sftp/thermometer/thermometer_pcb/Edge.Cuts.FCStd

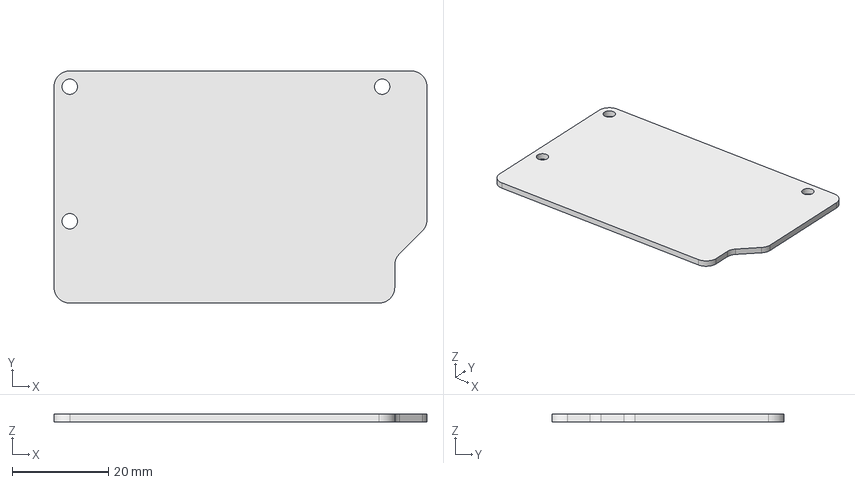
[picture p1: CAD file, 2020-10-15]
thermometer_pcb/Edge.Cuts.FCStd
77.6 x 48.3 x 1.60 mm
