sftp/thermometer/thermometer_pcb/thermometer_pcb.kicad_pcb

## KiCad design thermometer_pcb/thermometer_pcb.kicad_pcb (2024-02-26)

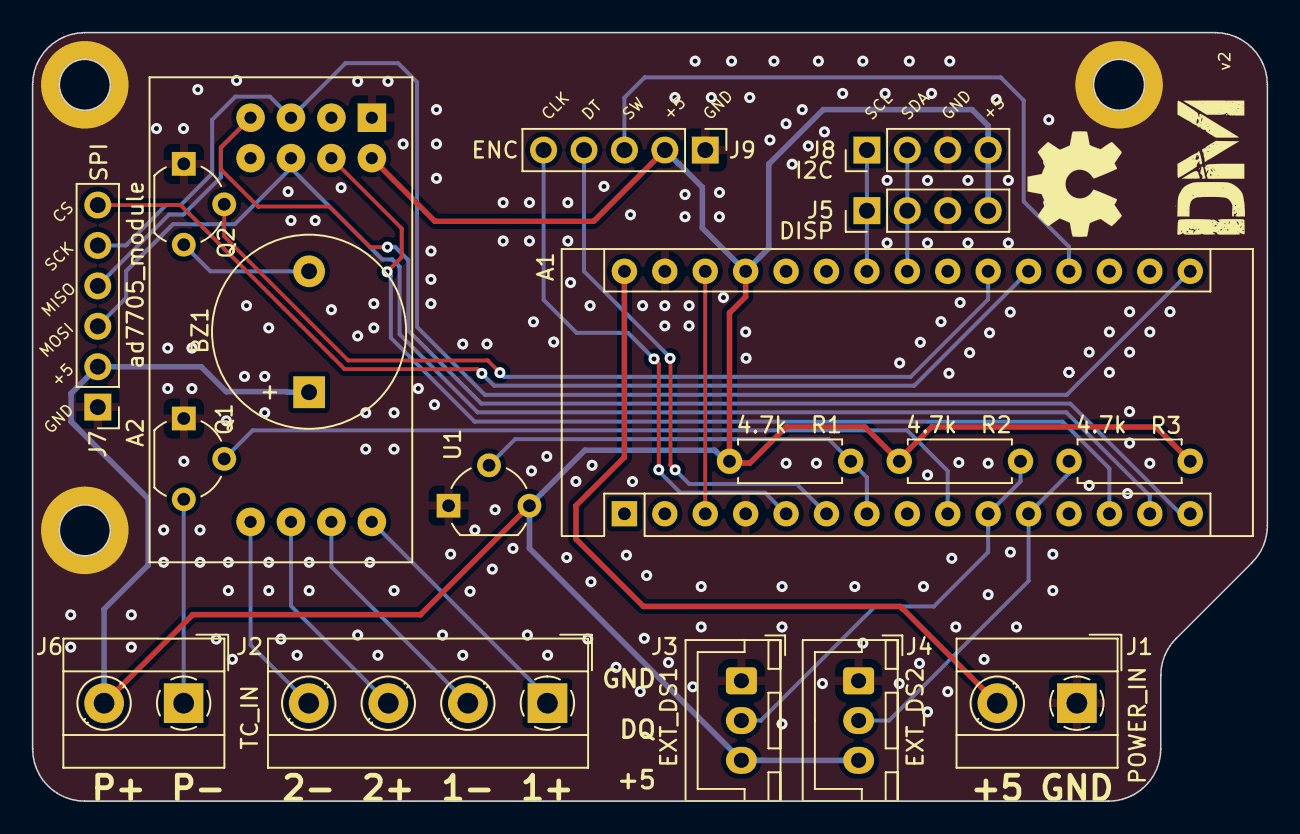
[picture p2: board thermometer_pcb.kicad_pcb from above]

Board: 2 copper layers, 77.6 x 48.3 mm, 23 parts (0 on the bottom side), 25 nets.

Parts:
A1: Arduino_Nano_v3.x; Arduino_Nano
A2: ad7705_module
BZ1: Buzzer; Buzzer_12x9.5RM7.6
H1, H2, H3: MountingHole_Pad; MountingHole_3.2mm_M3_ISO14580_Pad
J1: POWER_IN; TerminalBlock_MetzConnect_Type055_RT01502HDWU_1x02_P5.00mm_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
J2: TC_IN; TerminalBlock_MetzConnect_Type055_RT01504HDWU_1x04_P5.00mm_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
J3: EXT_DS1; JST_XH_B3B-XH-A_1x03_P2.50mm_Vertical
J4: EXT_DS2; JST_XH_B3B-XH-A_1x03_P2.50mm_Vertical
J5: DISP; PinHeader_1x04_P2.54mm_Vertical
J6: Conn_01x02; TerminalBlock_MetzConnect_Type055_RT01502HDWU_1x02_P5.00mm_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
J7: SPI; PinHeader_1x06_P2.54mm_Vertical
J8: I2C; PinHeader_1x04_P2.54mm_Vertical
J9: ENC; PinHeader_1x05_P2.54mm_Vertical
LOGO1: Logo_Open_Hardware_Small; OSHW-Symbol_6.7x6mm_SilkScreen
Q1, Q2: PN2222A; TO-92_Wide
R1, R2, R3: 4.7k; R_Axial_DIN0207_L6.3mm_D2.5mm_P7.62mm_Horizontal
SYM1: dm_logo
U1: DS18B20; TO-92_Wide

Connections:
+5V: A1.27, A2.2, BZ1.1, J3.3, J4.3, J5.4, J6.2, J7.2, J8.4, J9.2, R1.1, R2.1, R3.1, U1.3
/2: A1.5, J9.5
/3(**): A1.6, J9.4
/4: A1.7, R1.2, U1.2
/6(**): A1.9, Q1.2
/7: A1.10, J3.2, R2.2
/8: A1.11, J4.2, R3.2
/10(**/SS): A1.13, A2.4
/11(**/MOSI): A1.14, A2.6, J7.3
/12(MISO): A1.15, A2.7, J7.4
/13(SCK): A1.16, A2.5, J7.5
/A0: A1.19, J9.3
/A1: A1.20, J7.6
/A2: A1.21, Q2.2
/A4: A1.23, J5.2, J8.2
/A5: A1.24, J5.1, J8.1
/AIN1+: A2.9, J2.1
/AIN1-: A2.10, J2.2
/AIN2+: A2.11, J2.3
/AIN2-: A2.12, J2.4
/PID_OUT-: J6.1, Q1.3
/Reset: A1.3, A1.28
/Vin: A1.30, J1.2
GND: A1.4, A1.29, A2.1, H1.1, H2.1, H3.1, J1.1, J3.1, J4.1, J5.3, J7.1, J8.3, J9.1, Q1.1, Q2.1, U1.1
unnamed: BZ1.2, Q2.3
