sftp/thermometer/tc_pcb/tc_pcb.kicad_pcb

## KiCad design tc_pcb/tc_pcb.kicad_pcb (2024-02-26)

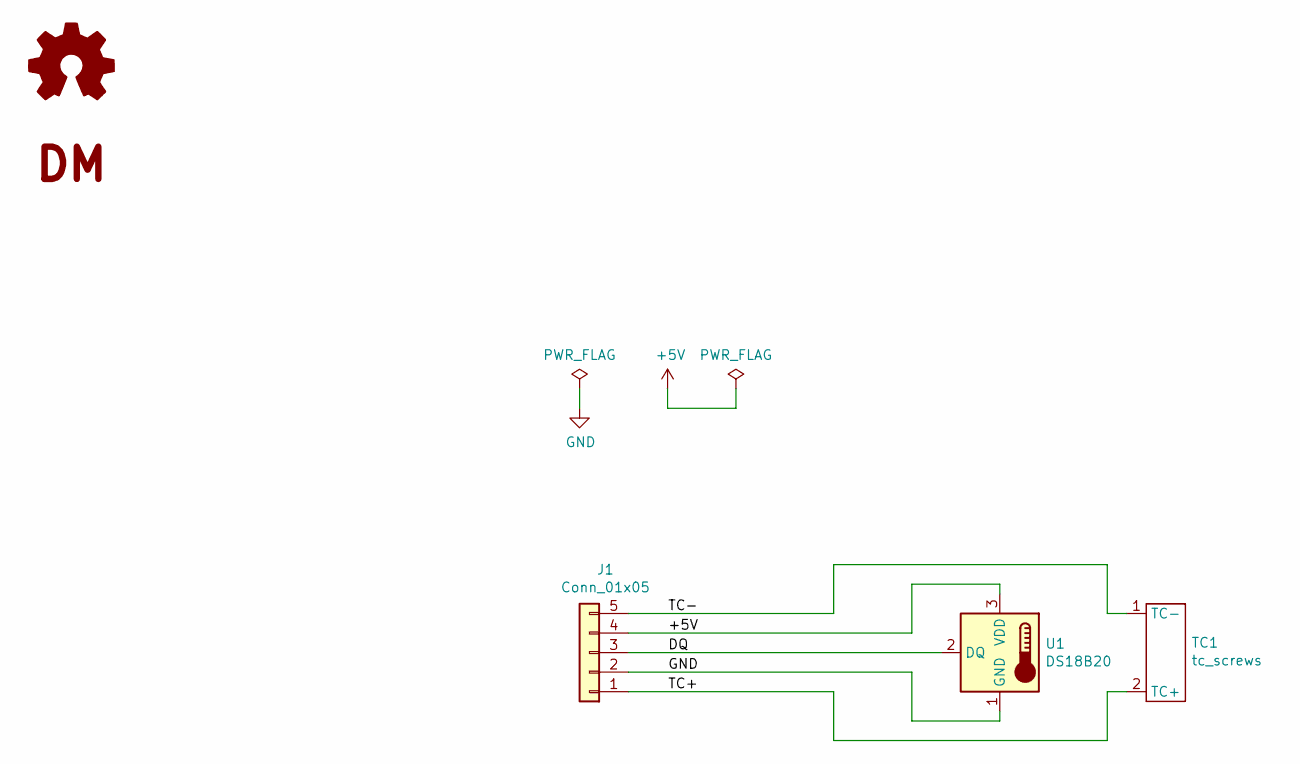
[picture p3: schematic tc_pcb.kicad_sch]

Parts:
J1: Conn_01x05; PinSocket_1x05_P2.54mm_Vertical
LOGO1: Logo_Open_Hardware_Small; OSHW-Symbol_6.7x6mm_SilkScreen
SYM1: dm_logo
TC1: tc_screws
U1: DS18B20; TO-92_W4.0mm_StaggerEven_Horizontal_FlatSideDown

Connections:
+5V: J1.4, U1.3 (VDD)
/DQ: J1.3, U1.2 (DQ)
/TC+: J1.1, TC1.2 (TC+)
/TC-: J1.5, TC1.1 (TC-)
GND: J1.2, U1.1 (GND)

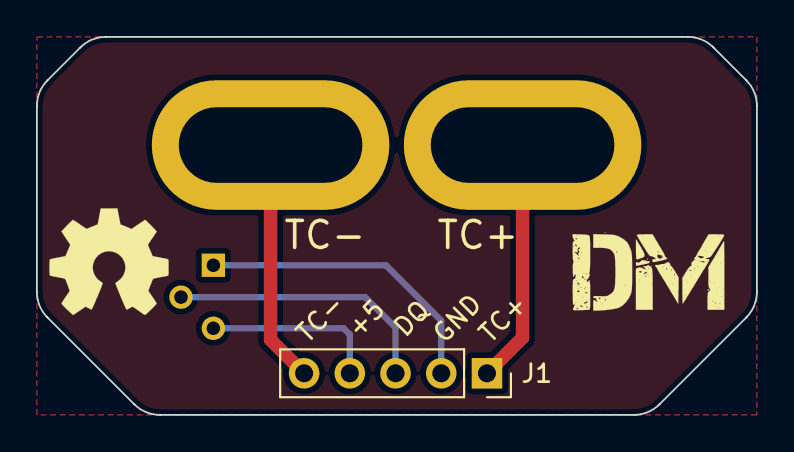
[picture p4: board tc_pcb.kicad_pcb from above]

Board: 2 copper layers, 40.0 x 21.0 mm, 5 parts (1 on the bottom side), 5 nets.
