sftp/thermometer/ad7705_pcb/ad7705_pcb.kicad_pcb

## KiCad design ad7705_pcb/ad7705_pcb.kicad_pcb (2020-07-26)

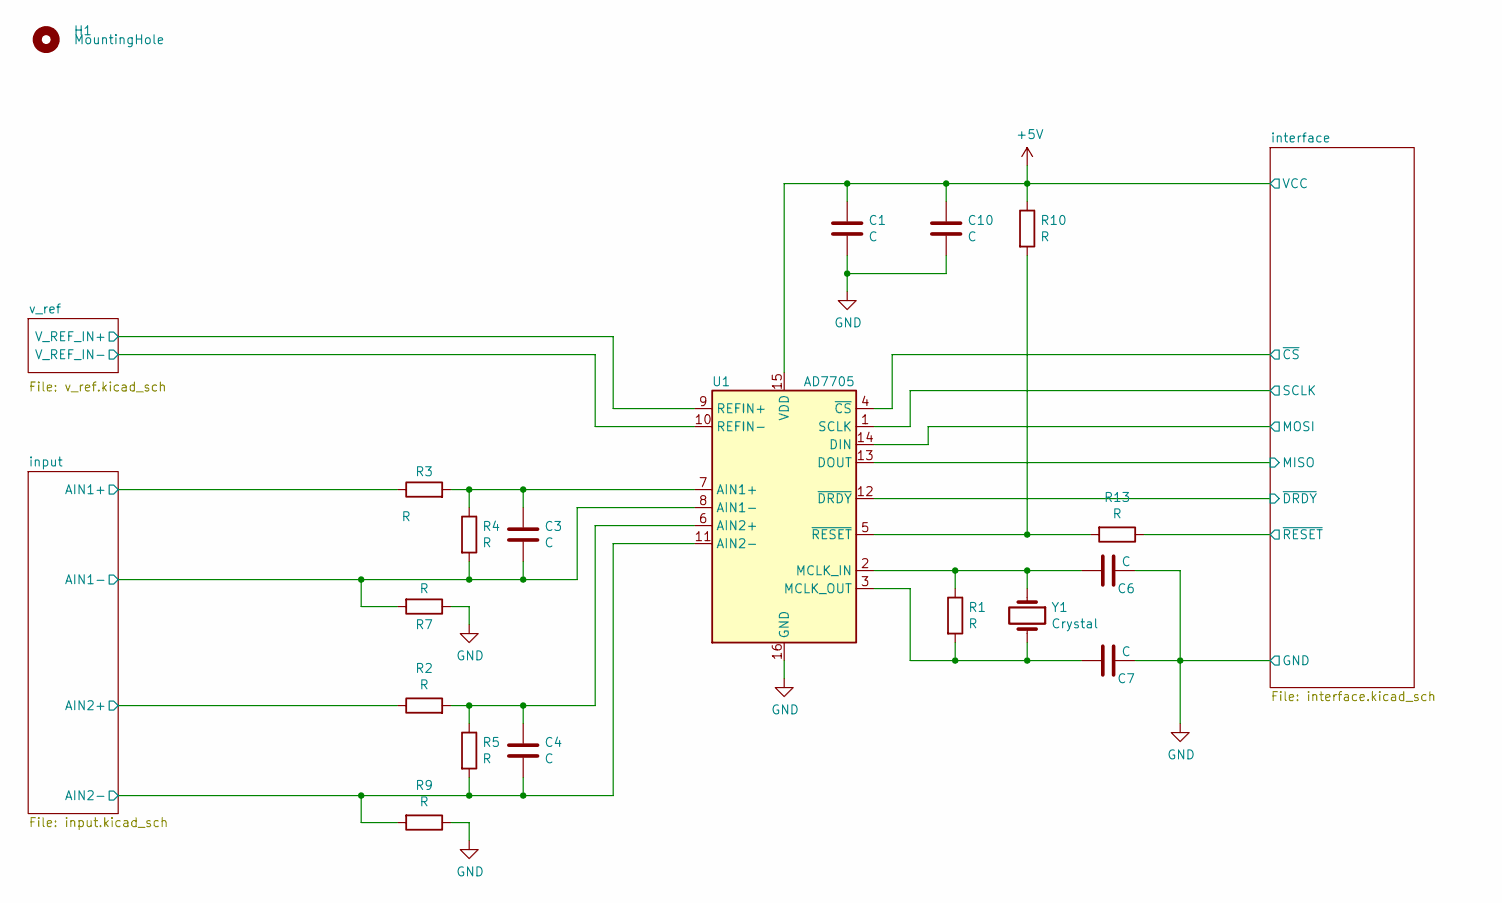
[picture p5: schematic ad7705_pcb.kicad_sch, AD7705 Module]

Parts:
C1, C3, C4, C6, C7, C10: C; C_0603_1608Metric
H1: MountingHole; MountingHole_2.2mm_M2_ISO7380
R1, R2, R3, R4, R5, R7, R9, R10, R13: R; R_0603_1608Metric
U1: AD7705; SOIC-16_4.55x10.3mm_P1.27mm
Y1: Crystal; Crystal_HC49-4H_Vertical

Connections:
+5V: C1.1, C10.1, R10.1, U1.15 (VDD); also elsewhere on the board
/AIN1+: R3.1; also elsewhere on the board
/AIN1-: C3.1, R4.2, R7.2, U1.8 (AIN1-); also elsewhere on the board
/AIN2+: R2.1; also elsewhere on the board
/AIN2-: C4.1, R5.2, R9.2, U1.11 (AIN2-); also elsewhere on the board
/MISO: U1.13 (DOUT); also elsewhere on the board
/MOSI: U1.14 (DIN); also elsewhere on the board
/SCLK: U1.1 (SCLK); also elsewhere on the board
/V_REF_IN+: U1.9 (REFIN+); also elsewhere on the board
/V_REF_IN-: U1.10 (REFIN-); also elsewhere on the board
/~CS: U1.4 (~CS); also elsewhere on the board
/~DRDY: U1.12 (~DRDY); also elsewhere on the board
/~RESET: R13.1; also elsewhere on the board
GND: C1.2, C6.1, C7.1, C10.2, R7.1, R9.1, U1.16 (GND); also elsewhere on the board
unnamed: C3.2, R3.2, R4.1, U1.7 (AIN1+)
unnamed: C4.2, R2.2, R5.1, U1.6 (AIN2+)
unnamed: C6.2, R1.1, U1.2 (MCLK_IN), Y1.1
unnamed: C7.2, R1.2, U1.3 (MCLK_OUT), Y1.2
unnamed: R10.2, R13.2, U1.5 (~RESET)

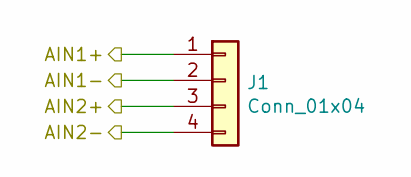
[picture p6: schematic input.kicad_sch, AD7705 Module]

Parts:
J1: Conn_01x04; PinHeader_1x04_P2.54mm_Vertical

Connections:
/AIN1+: J1.1; also elsewhere on the board
/AIN1-: J1.2; also elsewhere on the board
/AIN2+: J1.3; also elsewhere on the board
/AIN2-: J1.4; also elsewhere on the board

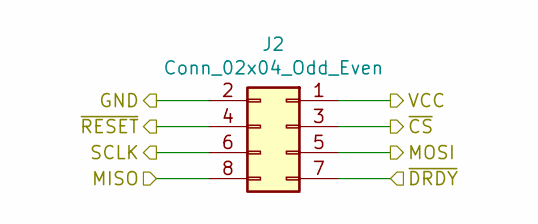
[picture p7: schematic interface.kicad_sch, AD7705 Module]

Parts:
J2: Conn_02x04_Odd_Even; PinHeader_2x04_P2.54mm_Vertical

Connections:
+5V: J2.1; also elsewhere on the board
/MISO: J2.8; also elsewhere on the board
/MOSI: J2.5; also elsewhere on the board
/SCLK: J2.6; also elsewhere on the board
/~CS: J2.3; also elsewhere on the board
/~DRDY: J2.7; also elsewhere on the board
/~RESET: J2.4; also elsewhere on the board
GND: J2.2; also elsewhere on the board

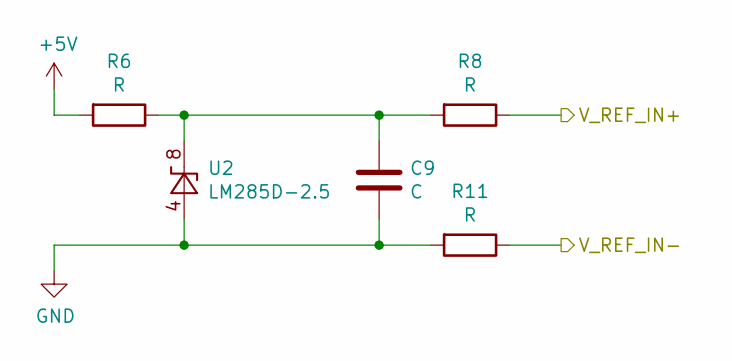
[picture p8: schematic v_ref.kicad_sch, AD7705 Module]

Parts:
C9: C; C_0603_1608Metric
R6, R8, R11: R; R_0603_1608Metric
U2: LM285D-2.5; SOIC-8_3.9x4.9mm_P1.27mm

Connections:
+5V: R6.2; also elsewhere on the board
/V_REF_IN+: R8.1; also elsewhere on the board
/V_REF_IN-: R11.1; also elsewhere on the board
GND: C9.2, R11.2, U2.4 (A); also elsewhere on the board
unnamed: C9.1, R6.1, R8.2, U2.8 (K)

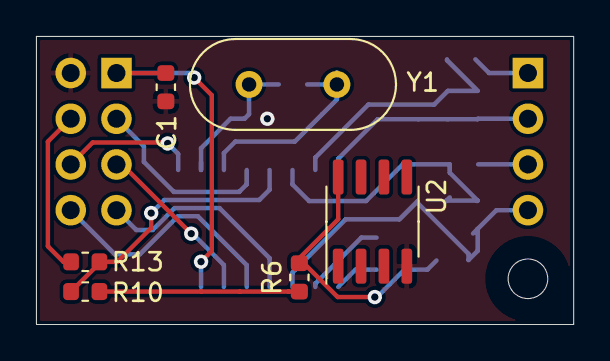
[picture p9: board ad7705_pcb.kicad_pcb from above]

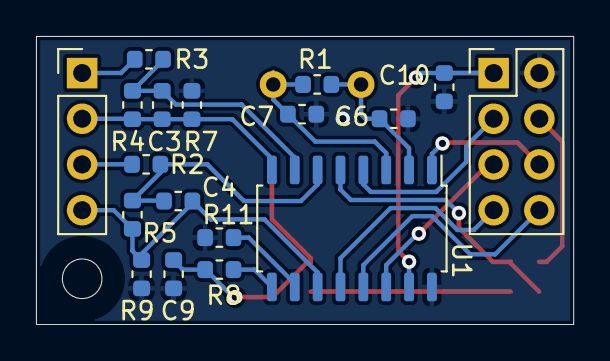
[picture p10: board ad7705_pcb.kicad_pcb from below]

Board: 2 copper layers, 29.8 x 16.0 mm, 25 parts (18 on the bottom side), 20 nets.
