sftp/thermometer/tc_k.h

#define TABLE_SIZE 1396
#define TABLE_STEP 33
#define TC_GAIN TC_GAIN_64

const uint16_t TABLE[TABLE_SIZE] PROGMEM = {
  0, /* t=0.0; mV=0.0; ADC=0 */
  9, /* t=0.9868700167607088; mV=0.03933906555175781; ADC=33 */
  19, /* t=1.9738946332880558; mV=0.07867813110351562; ADC=66 */
  29, /* t=2.9609894134174706; mV=0.11801719665527344; ADC=99 */
  39, /* t=3.9480744284351186; mV=0.15735626220703125; ADC=132 */
  49, /* t=4.935074124672115; mV=0.19669532775878906; ADC=165 */
  59, /* t=5.9219171936188655; mV=0.23603439331054687; ADC=198 */
  69, /* t=6.908536444527972; mV=0.2753734588623047; ADC=231 */
  78, /* t=7.8948686794743566; mV=0.3147125244140625; ADC=264 */
  88, /* t=8.880854570841494; mV=0.3540515899658203; ADC=297 */
  98, /* t=9.866438541202918; mV=0.3933906555175781; ADC=330 */
  108, /* t=10.851568645568385; mV=0.43272972106933594; ADC=363 */
  118, /* t=11.83619645596427; mV=0.47206878662109375; ADC=396 */
  128, /* t=12.820276948318122; mV=0.5114078521728516; ADC=429 */
  138, /* t=13.803768391617377; mV=0.5507469177246094; ADC=462 */
  147, /* t=14.786632239312661; mV=0.5900859832763672; ADC=495 */
  157, /* t=15.768833022936166; mV=0.629425048828125; ADC=528 */
  167, /* t=16.750338247905923; mV=0.6687641143798828; ADC=561 */
  177, /* t=17.731118291486972; mV=0.7081031799316406; ADC=594 */
  187, /* t=18.71114630288079; mV=0.7474422454833984; ADC=627 */
  196, /* t=19.69039810541422; mV=0.7867813110351562; ADC=660 */
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
  13683, /* t=1368.3102738166826; mV=54.759979248046875; ADC=45936 */
  13694, /* t=1369.4746384924258; mV=54.79931831359863; ADC=45969 */
  13706, /* t=1370.6397040486831; mV=54.83865737915039; ADC=46002 */
  13718, /* t=1371.8054723313448; mV=54.87799644470215; ADC=46035 */
};
