sftp/thermometer/tc_n.h

#define TABLE_SIZE 1329
#define TABLE_STEP 30
#define TC_GAIN TC_GAIN_64

const uint16_t TABLE[TABLE_SIZE] PROGMEM = {
  0, /* t=0.0; mV=0.0; ADC=0 */
  13, /* t=1.382265359451432; mV=0.035762786865234375; ADC=30 */
  27, /* t=2.7617742029994634; mV=0.07152557373046875; ADC=60 */
  41, /* t=4.138539433739884; mV=0.10728836059570312; ADC=90 */
  55, /* t=5.512573953056234; mV=0.1430511474609375; ADC=120 */
  68, /* t=6.883890659816768; mV=0.17881393432617187; ADC=150 */
  82, /* t=8.252502449579438; mV=0.21457672119140625; ADC=180 */
  96, /* t=9.618422213804884; mV=0.2503395080566406; ADC=210 */
  109, /* t=10.98166283907742; mV=0.286102294921875; ADC=240 */
  123, /* t=12.342237206333904; mV=0.3218650817871094; ADC=270 */
  137, /* t=13.700158190100607; mV=0.35762786865234375; ADC=300 */
  150, /* t=15.055438657737872; mV=0.3933906555175781; ADC=330 */
  164, /* t=16.408091468692703; mV=0.4291534423828125; ADC=360 */
  177, /* t=17.758129473759123; mV=0.4649162292480469; ADC=390 */
  191, /* t=19.10556551434635; mV=0.5006790161132812; ADC=420 */
  204, /* t=20.450412421754752; mV=0.5364418029785156; ADC=450 */
  217, /* t=21.792683016459467; mV=0.57220458984375; ADC=480 */
  231, /* t=23.132390107401815; mV=0.6079673767089844; ADC=510 */
  244, /* t=24.469546491288302; mV=0.6437301635742187; ADC=540 */
  258, /* t=25.804164951897327; mV=0.6794929504394531; ADC=570 */
  271, /* t=27.136258259393458; mV=0.7152557373046875; ADC=600 */
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
  12826, /* t=1282.6402590758762; mV=46.885013580322266; ADC=39330 */
  12836, /* t=1283.6245570477063; mV=46.9207763671875; ADC=39360 */
  12846, /* t=1284.6091484541673; mV=46.956539154052734; ADC=39390 */
  12855, /* t=1285.59403412985; mV=46.99230194091797; ADC=39420 */
  12865, /* t=1286.5792149115011; mV=47.0280647277832; ADC=39450 */
  12875, /* t=1287.5646916380288; mV=47.06382751464844; ADC=39480 */
  12885, /* t=1288.5504651505084; mV=47.09959030151367; ADC=39510 */
  12895, /* t=1289.5365362921875; mV=47.135353088378906; ADC=39540 */
  12905, /* t=1290.5229059084918; mV=47.17111587524414; ADC=39570 */
  12915, /* t=1291.5095748470299; mV=47.206878662109375; ADC=39600 */
  12924, /* t=1292.496543957599; mV=47.24264144897461; ADC=39630 */
  12934, /* t=1293.4838140921918; mV=47.278404235839844; ADC=39660 */
  12944, /* t=1294.4713861049993; mV=47.31416702270508; ADC=39690 */
  12954, /* t=1295.4592608524183; mV=47.34992980957031; ADC=39720 */
  12964, /* t=1296.4474391930555; mV=47.38569259643555; ADC=39750 */
  12974, /* t=1297.4359219877351; mV=47.42145538330078; ADC=39780 */
  12984, /* t=1298.4247100995008; mV=47.457218170166016; ADC=39810 */
  12994, /* t=1299.413804393625; mV=47.49298095703125; ADC=39840 */
};
