sftp/thermometer/tc_s.h

#define TABLE_SIZE 1845
#define TABLE_STEP 17
#define TC_GAIN TC_GAIN_128

const uint16_t TABLE[TABLE_SIZE] PROGMEM = {
  0, /* t=0.0; mV=0.0; ADC=0 */
  18, /* t=1.8659396971884046; mV=0.010132789611816406; ADC=17 */
  37, /* t=3.7160576078246255; mV=0.020265579223632812; ADC=34 */
  55, /* t=5.550937074162677; mV=0.03039836883544922; ADC=51 */
  73, /* t=7.371127498511109; mV=0.040531158447265625; ADC=68 */
  91, /* t=9.17714646847758; mV=0.05066394805908203; ADC=85 */
  109, /* t=10.969481771392832; mV=0.06079673767089844; ADC=102 */
  127, /* t=12.74859330210337; mV=0.07092952728271484; ADC=119 */
  145, /* t=14.514914868222037; mV=0.08106231689453125; ADC=136 */
  162, /* t=16.2688558968262; mV=0.09119510650634766; ADC=153 */
  180, /* t=18.010803046495408; mV=0.10132789611816406; ADC=170 */
  197, /* t=19.741121728483293; mV=0.11146068572998047; ADC=187 */
  214, /* t=21.460157540722843; mV=0.12159347534179687; ADC=204 */
  231, /* t=23.168237618269377; mV=0.13172626495361328; ADC=221 */
  248, /* t=24.865671903692174; mV=0.1418590545654297; ADC=238 */
  265, /* t=26.552754340833367; mV=0.1519918441772461; ADC=255 */
  282, /* t=28.229763995261333; mV=0.1621246337890625; ADC=272 */
  298, /* t=29.89696610465598; mV=0.1722574234008789; ADC=289 */
  315, /* t=31.55461306227415; mV=0.1823902130126953; ADC=306 */
  332, /* t=33.20294533655586; mV=0.19252300262451172; ADC=323 */
  348, /* t=34.84219232984512; mV=0.20265579223632812; ADC=340 */
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
  16901, /* t=1690.1206531896023; mV=17.833709716796875; ADC=29920 */
  16909, /* t=1690.9990277509642; mV=17.84384250640869; ADC=29937 */
  16918, /* t=1691.8779450418297; mV=17.853975296020508; ADC=29954 */
  16927, /* t=1692.7574172057066; mV=17.864108085632324; ADC=29971 */
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
