sftp/thermometer/(commit log)

2017-07-04 wxmaxima: switch from wxmx to plaintext wxm format
2017-07-04 add support of cold junction compensation
    Use ds18b20 sensor for to compensate cold junction temperature. Sensor
    should be mounted near with cold junction of thermocouple to measute
    reference temperature.
2017-07-08 wxmaxima/tnn: use t_max value when plot ADC(t) graph
2017-07-08 use linear interpolation to calculate temperature
    This allows to save memory by reducing TNN table to 1 degree
    resolution, then calculate temperature using interpolation.
2018-12-31 config.h: change display pins (prepare for pcb)
2019-01-01 config.h: change ds18b20 pin (prepare for pcb)
2019-02-17 tc.h: fix type in S-type include
    [tc.h]
2019-07-01 new tc tables: use t(ADC) tables
    Using t(ADC) tables allows to lookup t in one step (O(1)), no need to
    bisect in ADC(t) table.
2019-07-02 add support of external ds18b20 cold junction compensation sensor
    If connected, external sensor will be used for cold junction compensation.
    Otherwise, fallback to internal sensor.
2019-07-04 ds18b20: do not wait for conversion
    Use timer (millis()) to ensure conversion is done.
2019-07-04 pcb: add initial pcb
    [thermometer_pcb.kicad_pcb, thermometer_pcb.sch]
2019-07-05 pcb: add gitignore for thermometer_pcb
2019-07-05 thermometer_pcb/gitignore: ignore gerber files
2019-07-05 thermometer_pcb/gitignore: ignore drill files
2019-07-05 thermometer_pcb/gitignore: ignore .kicad_pcb-bak
2019-07-05 pcb: add7705_module: flip to another side
    [thermometer_pcb.kicad_pcb]
2019-07-05 pcb: add7705_module footprint: remove B.Silk
2019-07-05 pcb: update add7705_module footprint from lib
    [thermometer_pcb.kicad_pcb]
2019-07-05 pcb: fix J2 connector pads order
    [thermometer_pcb.kicad_pcb, thermometer_pcb.sch]
2019-07-07 pcb: change connectors for ds18b20 sensors
    [thermometer_pcb.kicad_pcb, thermometer_pcb.sch]
2019-07-07 prepare new pcb shape
    [thermometer_pcb.kicad_pcb, thermometer_pcb.sch]
2019-07-07 pcb: minor cleanups
    [thermometer_pcb.kicad_pcb]
2019-07-08 pcb: minor traces shape improvement
    [thermometer_pcb.kicad_pcb]
2019-07-08 pcb: add micro vias
    [thermometer_pcb.kicad_pcb]
2019-07-08 pcb: add more via stitching
    [thermometer_pcb.kicad_pcb]
2019-07-08 pcb: add silkscreen text for conns
    [thermometer_pcb.kicad_pcb]
2019-07-08 pcb: drc cleanups
    [thermometer_pcb.kicad_pcb]
2019-07-15 pcb: add pid connector
    [thermometer_pcb.kicad_pcb, thermometer_pcb.sch]
2019-07-15 pcb: remove wrong micro-via
    [thermometer_pcb.kicad_pcb]
2019-07-15 pcb: move logos
    [thermometer_pcb.kicad_pcb]
2019-07-15 pcb: move transistor nearer to conn
    [thermometer_pcb.kicad_pcb]
2019-07-25 get rid of delay() call
    Use millis() timer value to determine if task need to be executed.
2019-08-04 pcb: move conns and it's silkscreen
    [thermometer_pcb.kicad_pcb]
2019-08-04 pcb: add pid conn silkscreen
    [thermometer_pcb.kicad_pcb]
2019-08-04 pcb: move J6 silkscreen
    [thermometer_pcb.kicad_pcb]
2019-08-04 pcb: move TC conn silkscreen
    [thermometer_pcb.kicad_pcb]
2019-08-04 pcb: reroute PID+ track
    [thermometer_pcb.kicad_pcb]
2019-08-04 pcb: make +5V track shorter
    [thermometer_pcb.kicad_pcb]
2019-08-17 pcb: reroute all nets; move resistors
    [thermometer_pcb.kicad_pcb]
2019-08-17 pcb: add SPI pinheader
    [thermometer_pcb.kicad_pcb, thermometer_pcb.sch]
2019-08-17 pcb: add buzzer
    [thermometer_pcb.kicad_pcb, thermometer_pcb.sch]
2019-08-17 pcb: add I2C pinheader
    [thermometer_pcb.kicad_pcb, thermometer_pcb.sch]
2019-08-17 pcb: add SPI pins silkscreen
    [thermometer_pcb.kicad_pcb]
2019-08-17 pcb: rotate Q1 silkscreen
    [thermometer_pcb.kicad_pcb]
2019-08-17 pcb: add I2C pins silkscreen
    [thermometer_pcb.kicad_pcb]
2019-08-17 pcb: move R{1,2,3} silkscreen
    [thermometer_pcb.kicad_pcb]
2019-08-17 pcb: change DS18 pins
    [thermometer_pcb.kicad_pcb, thermometer_pcb.sch]
2019-08-17 pcb: add encoder pinheader
    [thermometer_pcb.kicad_pcb, thermometer_pcb.sch]
2019-08-17 pcb: fix tracks shape
    [thermometer_pcb.kicad_pcb]
2019-08-17 pcb: add microvias
    [thermometer_pcb.kicad_pcb]
2019-08-17 pcb: add microvia
    [thermometer_pcb.kicad_pcb]
2019-08-17 pcb: fix track shape
    [thermometer_pcb.kicad_pcb]
2019-08-17 pcb: swap layers
    [thermometer_pcb.kicad_pcb]
2019-08-17 pcb: add version to silkscreen
    [thermometer_pcb.kicad_pcb]
2019-08-18 pcb: big via for +5v
    [thermometer_pcb.kicad_pcb]
2019-08-26 gitignore: move pcb ignores to root gitignore
2019-08-26 pcb: add thermocouple pcb
    [tc_pcb.kicad_pcb, tc_pcb.sch]
2019-09-08 pcb: use A0 for encoders switch
    [thermometer_pcb.kicad_pcb, thermometer_pcb.sch]
2019-09-08 pcb: use A1 for external SPI CS
    [thermometer_pcb.kicad_pcb, thermometer_pcb.sch]
2019-09-08 pcb: use A2 for buzzer
    [thermometer_pcb.kicad_pcb, thermometer_pcb.sch]
2019-09-08 pcb: move some tracks to back layer
    [thermometer_pcb.kicad_pcb]
2019-09-08 pcb: version v2
    [thermometer_pcb.kicad_pcb]
2019-09-08 pcb: align some tracks
    [thermometer_pcb.kicad_pcb]
2019-09-08 pcb: remove wrong track segment
    [thermometer_pcb.kicad_pcb]
2019-09-08 pcb: get rid of via on Vin track
    [thermometer_pcb.kicad_pcb]
2019-09-08 pcb: align J{1,2,3,4,6} Silk label
    [thermometer_pcb.kicad_pcb]
2019-09-22 add initial support of PID control with encoder setup
2019-09-22 pid: fix conservative params applying
    [thermometer.ino]
2019-09-28 pid: write setpoint to eeprom
2019-09-28 tasks: use uint32_t for ms (millis since start) variable
2019-09-29 pid: tune P and I
2019-09-30 encoder: configure direction with config
2019-09-30 encoder: set direction to -1 by default
2019-10-05 recalc t after adc read
2019-10-05 fix ms used in debug output
    [thermometer.ino]
2019-10-05 use ms variable instead of millis() call when possibple
2019-10-05 pid: do not use conservotive PID params by default
2020-01-08 gitignore: ignore pcb rescue files
2020-01-08 gitignore: ignore pcb's sym-lib-table
2020-07-22 add ad7705_module kicad project
    [ad7705_pcb.kicad_pcb, ad7705_pcb.kicad_sch, input.kicad_sch, interface.kicad_sch, v_ref.kicad_sch]
2020-07-22 ad7705_pcb: fix silk
    [ad7705_pcb.kicad_pcb]
2020-07-22 gitignore: ignore *.kicad_prl
2020-07-22 thermometer_pcb: move to new kicad
    [thermometer_pcb.kicad_pcb, thermometer_pcb.kicad_sch, thermometer_pcb.sch]
2020-07-22 tc_pcb: move to new kicad
    [tc_pcb.kicad_pcb, tc_pcb.kicad_sch, tc_pcb.sch]
2020-07-22 kicad-lib: tc_screws: new file format
2020-07-22 kicad-lib: AD7705: new file format
2020-07-22 kicad-lib: ad7705_module: new file format
2020-07-22 kicad-lib: dm_logo: new file format
2020-07-26 pcb: tune corners radius
    [thermometer_pcb.kicad_pcb]
2020-07-26 pcb: move some traces
    [thermometer_pcb.kicad_pcb]
2020-07-26 pcb: use nicro-via for CLK and DT encoder lines
    [thermometer_pcb.kicad_pcb]
2020-07-26 pcb: use micro-via for SS, MISO, A1, A2 lines
    [thermometer_pcb.kicad_pcb]
2020-07-26 tc_pcb: remove redundand labels
    [tc_pcb.kicad_sch]
2020-07-26 tc_pcb: set dimensions in mils
    [ad7705_pcb.kicad_pcb]
2020-10-15 pcb: change dimensions
    [Edge.Cuts.FCStd, thermometer_pcb.kicad_pcb]
2020-10-15 gitignore: ignore pcb's dxf files
2020-10-15 gitignore: ignore kicad autosave files
2020-10-15 pcb: remove dimensions on copper layer
    [thermometer_pcb.kicad_pcb]
2024-02-26 move to kicad 8
    [tc_pcb.kicad_pcb, tc_pcb.kicad_sch, thermometer_pcb.kicad_pcb, thermometer_pcb.kicad_sch]
